alvinhdr/fpga-vision-inspection/data/photos/b1_passthrough_desktop_2026-10-18.jpg

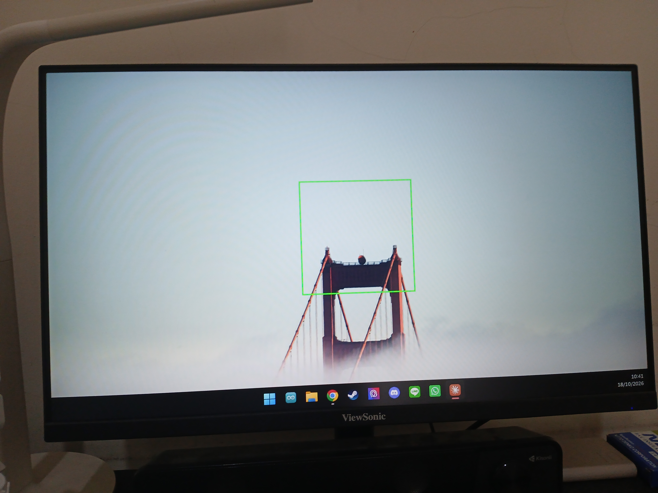
data/photos/b1_passthrough_desktop_2026-10-18.jpg
