alvinhdr/fpga-vision-inspection/data/photos/b2/b2_demo_frame_empty_white.jpg

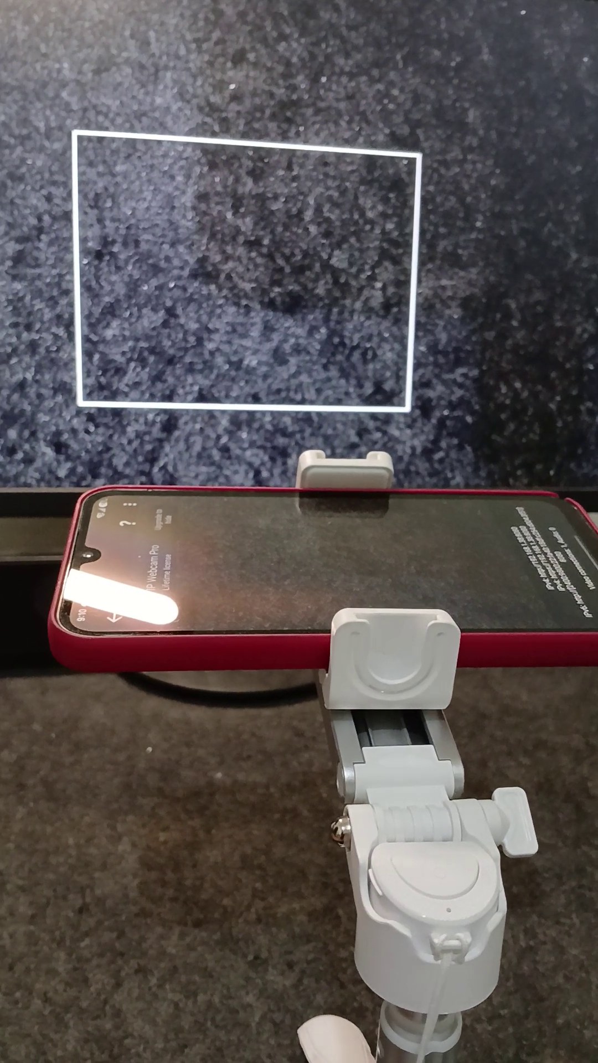
data/photos/b2/b2_demo_frame_empty_white.jpg
