alvinhdr/fpga-vision-inspection/data/photos/b2/b2_demo_frame_FAIL_red_short_part.jpg

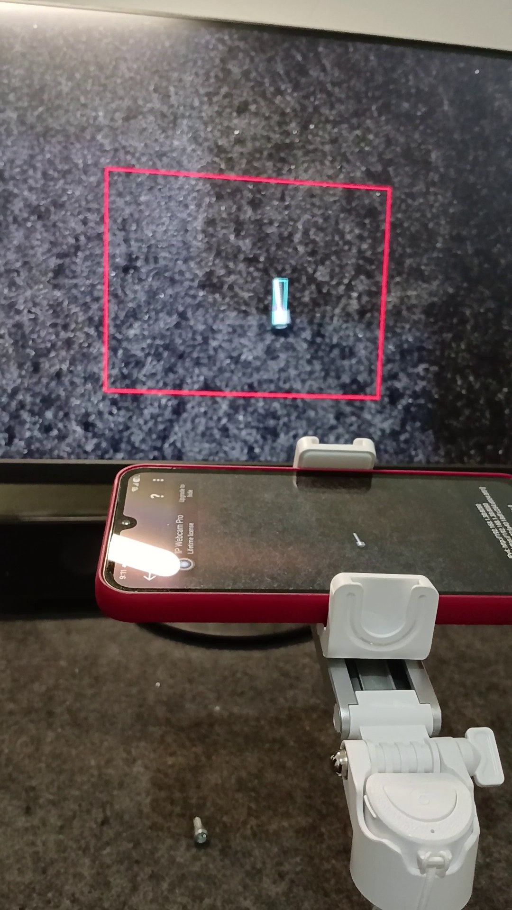
data/photos/b2/b2_demo_frame_FAIL_red_short_part.jpg
