alvinhdr/fpga-vision-inspection/data/photos/b2/b2_demo_frame_PASS_green.jpg

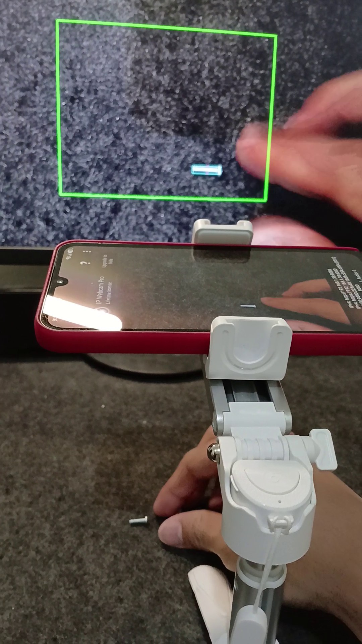
data/photos/b2/b2_demo_frame_PASS_green.jpg
