alvinhdr/fpga-vision-inspection/data/photos/b2/b2_monitor_PASS_green_closeup.jpg

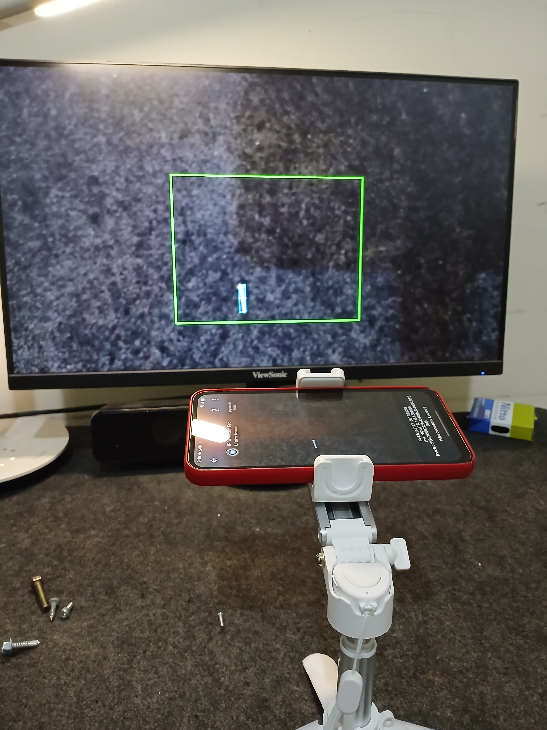
data/photos/b2/b2_monitor_PASS_green_closeup.jpg
