alvinhdr/fpga-vision-inspection/data/photos/part_types_s1.png

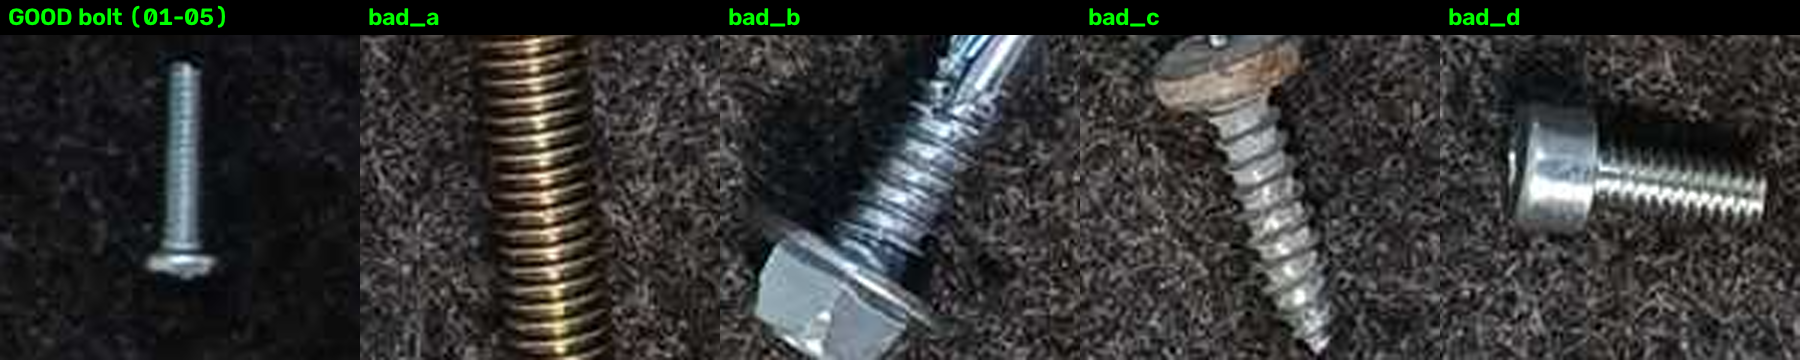
data/photos/part_types_s1.png
