alvinhdr/fpga-vision-inspection/data/photos/b2/b2_setup_overview_1.jpg

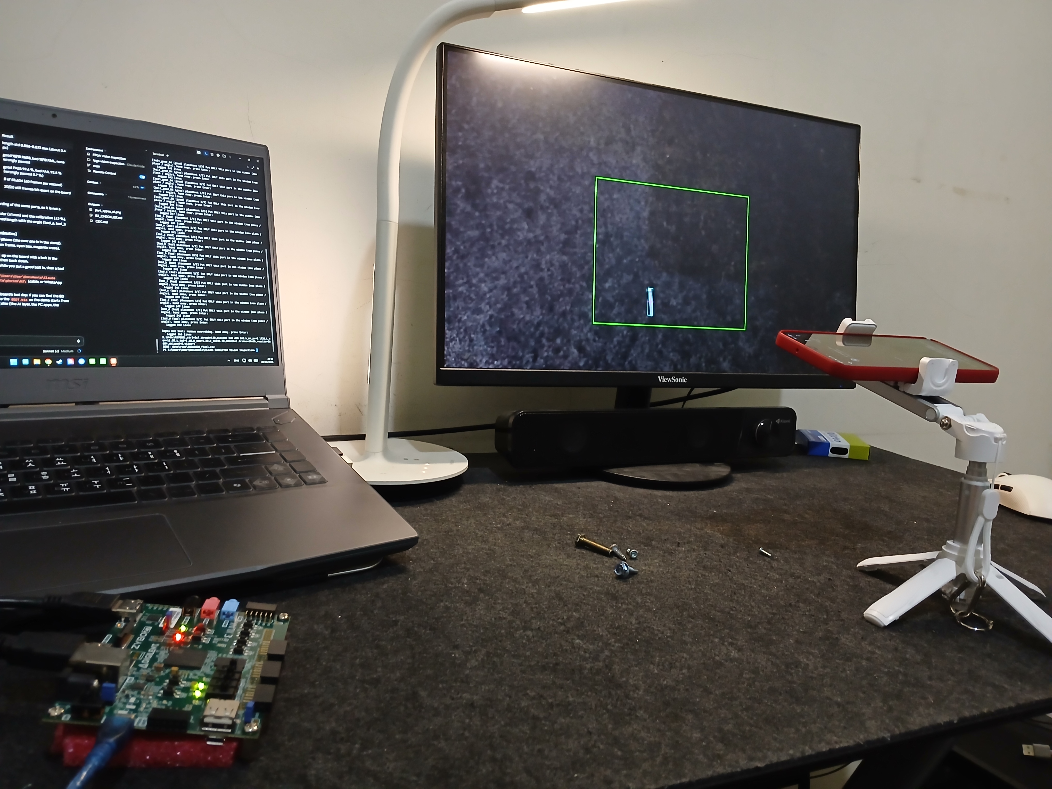
data/photos/b2/b2_setup_overview_1.jpg
