alvinhdr/fpga-vision-inspection/(commit log)

2026-10-18 B1: pass-through works on the board, photo and notes
2026-10-18 B1: camera chain via IP Webcam, first frames, bolt size measured
2026-10-18 B1 closed: about 1 h board time, 17 cm frame measured, notes
2026-10-18 M1: first 147 frames captured (s1), notes
2026-10-18 M1: 285 frames, two brightness regimes found, notes and LEARNING
2026-10-18 M1: parts table with ruler estimates
    [parts.csv]
2026-10-18 M5 prep: register map, UART protocol, ARM maths in C (matches Python on 285 frames), main.c, UART logger
2026-10-18 ARM app builds: link maths library, notes
2026-10-19 Notes: board last day 21 Oct, updated job list summary
2026-10-19 M4: measurement core RTL (threshold, 3x3 filter, moment sums, bbox), result banks, AXI registers, overlay, new top; timing met (WNS +0.906 ns)
2026-10-19 M4: RTL review fixes (bank pointer derived from toggle, register init values, flush cleared at sof), stronger tests, ARM skips results after window change; timing met (WNS +1.060 ns)
    [axil_insp.sv, insp_overlay.sv, main.c, meas_core.sv, sim_meas.py, tb_axil_insp.sv, tb_meas_core.sv]
2026-10-19 B2 checklist, on-board still test script, notes
2026-10-20 B2: board programmed, still test 20/20 bit-exact on hardware
2026-10-20 B2: s2 captured with new phone, ruler calibration 0.1728 mm/px, offline results
2026-10-20 ARM: median-of-9 smoothing, width check (v), g command; evidence tool uses final rule
    [20261020_evidence.csv]
2026-10-20 ARM v3: skip noisy frames in the median instead of resetting; notes on the first evidence runs
    [20261020_v2_smoothing_reset_bug.csv]
2026-10-20 analyze_evidence.py, notes: mouse pointer found as second object
    [20261020_v3_mouse_pointer_in_picture.csv]
2026-10-20 B2: final evidence (repeatability 0.06 mm, 15/15 good PASS, 11/12 bad FAIL, 0 skipped results)
    [20261020_final.csv]
2026-10-20 B2 complete: demo photos/stills, frame-rate test, build artifacts backup, reports, BOOT.bin built (untested)
2026-10-20 Python viewer with replay; stale-line correction of the evidence analysis; RESULTS/README numbers corrected
    [analyze_evidence.py, uart_log.py, viewer.py]
2026-10-20 AI layer: offline evaluation on real board results (type recognition, unseen-defect rejection), docs
